reso-nance/gmem-sirva/doc/module.png

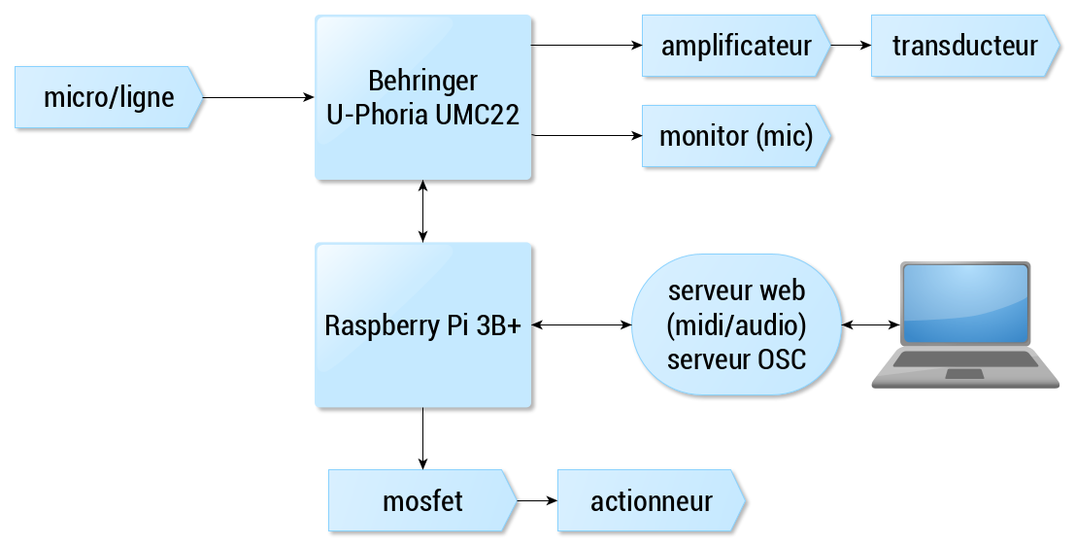
doc/module.png
