reso-nance/gmem-sirva/estimRéplication.ods

Sheet: sans Trig
un module sans trig
Item | Qté | P.U. | P.T | lien
kit Raspberry Pi 3 B+ | 1 | 86,91 € | 86,91 € | https://www.kubii.fr/home/2121-starter-kit-officiel-pi-3-b-kubii-3272496009998.html
carte son UMC202HD | 1 | 66,00 € | 66,00 € | https://www.thomann.de/fr/behringer_u_phoria_umc202hd.htm
ampli audio 10W LM315 | 1 | 9,99 € | 9,99 € | https://www.amazon.fr/ICQUANZX-Simple-dalimentation-Amplificateur-TDA2030A/
embase jack 6.35 | 1 | 7,09 € | 7,09 € | https://www.amazon.fr/Sharplace-6-35mm-Nickel-Plaqué-Terminal/dp/B07D41536V/
embase XLR | 1 | 11,90 € | 11,90 € | https://www.amazon.fr/Embase-Points-Connecteur-Adaptateur-Soudure/dp/B082TZ3G8R/
5x PMMA coulé 4x500x500mm | 1 | 28,97 € | 28,97 € | https://www.polydis.fr/epages/8d7c81fe-552a-11e0-822f-000d609a287c.sf/fr_FR/
Mosfet IRLZ34N | 1 | 17,00 € | 17,00 € | https://www.amazon.fr/DIPU-WULIAN-IRLZ34N-IRLZ34-Effect/dp/B07TWPRW9X
Bras articulé 11’ avec pince | 2 | 27,44 € | 54,88 € | https://www.amazon.fr/Sinvitron-Magique-appareil-numérique-moniteur/dp/B011769YUM/r
Pince vis 1/4 | 2 | 12,50 € | 25,00 € | https://www.amazon.fr/SMALLRIG-Magique-Super-Clamp-Adaptateur/dp/B07F2WRHHF/
câbles, quincaillerie, consommables | 1 | 10,00 € | 10,00 €
Total matériel |  |  | 317,74 €
Installation OS et configuration | 0,5 | 350,00 € | 175,00 €
Fabrication et assemblage boitier | 0,5 | 350,00 € | 175,00 €
Câblage et installation en boitier | 1 | 350,00 € | 350,00 €
Assemblage méca et tests | 2 | 350,00 € | 700,00 €
total main d’oeuvre |  |  | 1 400,00 €
 |  | Total : | 1 717,74 €

Sheet: avec Trig
un module avec trig
Item | Qté | P.U. | P.T | lien
kit Raspberry Pi 3 B+ | 1 | 86,91 € | 86,91 € | https://www.kubii.fr/home/2121-starter-kit-officiel-pi-3-b-kubii-3272496009998.html
carte son UMC202HD | 1 | 66,00 € | 66,00 € | https://www.thomann.de/fr/behringer_u_phoria_umc202hd.htm
ampli audio 10W LM315 | 1 | 9,99 € | 9,99 € | https://www.amazon.fr/ICQUANZX-Simple-dalimentation-Amplificateur-TDA2030A/
embase jack 6.35 | 1 | 7,09 € | 7,09 € | https://www.amazon.fr/Sharplace-6-35mm-Nickel-Plaqué-Terminal/dp/B07D41536V/
embase XLR | 1 | 11,90 € | 11,90 € | https://www.amazon.fr/Embase-Points-Connecteur-Adaptateur-Soudure/dp/B082TZ3G8R/
5x PMMA coulé 4x500x500mm | 1 | 28,97 € | 28,97 € | https://www.polydis.fr/epages/8d7c81fe-552a-11e0-822f-000d609a287c.sf/fr_FR/
MCP3008 | 1 | 5,91 € | 5,91 € | https://www.amazon.fr/MCP3008-Analog-Digital-Converters-10-bit/dp/B01C3PPWSY/
LED RGB 5mm | 1 | 4,69 € | 4,69 € | https://www.amazon.fr/Ruiting-Emitting-Pratique-Produits-Articles/dp/B07HKCP86C/
Potentiomètres 10k linéaires | 1 | 8,99 € | 8,99 € | https://www.amazon.fr/Hseamall-Potentiomètre-rotatif-linéaire-rondelle/dp/B073PQ2G82
PCB simple couche | 1 | 72,00 € | 72,00 € | https://www.pcbway.com/
Mosfet IRLZ34N | 1 | 17,00 € | 17,00 € | https://www.amazon.fr/DIPU-WULIAN-IRLZ34N-IRLZ34-Effect/dp/B07TWPRW9X
Bras articulé 11’ avec pince | 2 | 27,44 € | 54,88 € | https://www.amazon.fr/Sinvitron-Magique-appareil-numérique-moniteur/dp/B011769YUM/r
Pince vis 1/4 | 2 | 12,50 € | 25,00 € | https://www.amazon.fr/SMALLRIG-Magique-Super-Clamp-Adaptateur/dp/B07F2WRHHF/
câbles, quincaillerie, consommables | 1 | 10,00 € | 10,00 €
Total matériel |  |  | 409,33 €
conception PCB | 1,5 | 350,00 € | 525,00 €
Installation OS et configuration | 0,5 | 350,00 € | 175,00 €
Câblage shield raspberry pi | 0,5 | 350,00 € | 175,00 €
Fabrication et assemblage boitier | 0,5 | 350,00 € | 175,00 €
Câblage et installation en boitier | 1 | 350,00 € | 350,00 €
Assemblage méca et tests | 2 | 350,00 € | 700,00 €
total main d’oeuvre |  |  | 2 100,00 €
Total premier module |  |  | 2 509,33 €
Total modules suivants |  |  | 1 912,33 €
