reso-nance/gmem-sirva/hardware/adaptateurSolenoide/Non-Std-Threads.stl

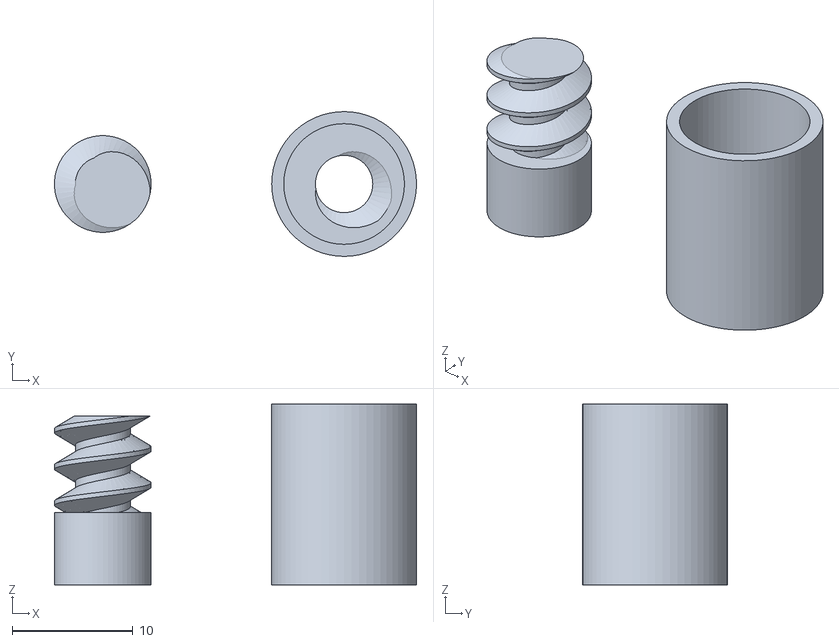
[picture p2: CAD file, 2019-11-29]
hardware/adaptateurSolenoide/Non-Std-Threads.stl
30.0 x 12.0 x 15.0
