reso-nance/gmem-sirva/(list of files, cad)

Other CAD files:
hardware/adaptateurSolenoide/UM2_Non-Std-Threads.stl
