reso-nance/gmem-sirva/(threads)

Thread 4 (2019-10-15):

clients : output volume

reso-nance, 2019-10-15:
the audio volume of each output should be set via OSC. Client should notify the server of it's current volumes on change.

reso-nance, 2019-11-06:
volumes can now be set and read via OSC : set volumes a24e55d9e4c44c3cbd34238cc775979eb2401833 fixed 311877579f709d1556336eedb729a419a5d7334e read volumes 3a40577a17f5b31ae63bd38b483a76863600cbe8

Closed 2019-11-06.
