reso-nance/gmem-sirva/client/main.py

#!/usr/bin/env python
# -*- coding: utf-8 -*-
#
#  client/main.py
#  
#  Copyright 2019 Reso-nance Numérique <laurent@reso-nance.org>
#  
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
#  

from threading import Thread
from time import sleep
import signal, subprocess, atexit, os
import OSCserver, peakDetector, audio

oscServerThread = None
heartbeatThread = None
peakDetectorThread = None
JACKconnectionThread = None

def exitCleanly(*args): #args may contain SIGnumber and other info when called from atexit
    if oscServerThread : 
        print("stopping the heartbeat")
        OSCserver.heartbeat = False
        heartbeatThread.join()
        print("closing the OSC server")
        OSCserver.runServer = False
    if peakDetector :
        print("closing the peak detector")
        peakDetector.isListening = False
        peakDetector.stopListening()
    print("exiting jack client ...")
    audio.close()
    
    raise SystemExit



if __name__ == '__main__':
    signal.signal(signal.SIGTERM, exitCleanly) # register this exitCleanly function to be called on sigterm
    atexit.register(exitCleanly) # idem when called from within this script
    if not os.path.isdir(audio.wavDir) : os.mkdir(audio.wavDir) # create the wav directory if it does'nt already exists
    print("starting the OSC server...")
    oscServerThread = Thread(target=OSCserver.listen)
    oscServerThread.start()
    print("starting the heartbeat thread ...")
    heartbeatThread = Thread(target = OSCserver.sendHeartbeat)
    heartbeatThread.start()
    print("starting the audio peak detector...")
    peakDetectorThread = Thread(target=peakDetector.listen)
    peakDetectorThread.start()
    print("starting the JACK connection thread...")
    JACKconnectionThread = Thread(target=audio.init, kwargs=audio.jackParameters)
    JACKconnectionThread.start()
    

    while True :
        try : sleep(1)
        except KeyboardInterrupt : exitCleanly()
