reso-nance/gmem-sirva/(commit log)

2019-09-10 added a setup script added an OSCserver added a midi file player sending OSC packages to local addresses stored in a json midi-hostnames containing the velocity of the note played
2019-09-10 added untested client code : convert note velocity to gpio high duration to actuate the solenoid according to the midi velocity
2019-09-11 added a peak detector for the client added an OSC server for the client added and tested basic GPIO functions deployed and fixed client setup script
    [OSCserver.py, main.py, peakDetector.py, solenoid.py]
2019-09-12 added SPI support to read potentiometers through MCP3008 on the client side cleaned peak detector code added OSC server back in the repo
2019-09-18 fixed threads won't exit cleanly soundcard is now found by it's name in both ALSA and OSS enumeration protocols added an RBG led with signal/peak functionnality commented client code
    [OSCserver.py, main.py, peakDetector.py, solenoid.py]
2019-09-30 tested and fixed OSC mute, unmute, toggle, route on all channels cleaned and commented audio code added some xrun stats to ease tweaking jack parameters removed jack process callback (not used anymor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
    [OSCserver.py, audio.py, main.py, solenoid.py]
2019-10-28 added a heartbeat with discovery from clients to server. New clients are asked to send their local IP, volumes from alsamixer, wav files list and assigned midi note to the server clients can read the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
    [OSCserver.py, audio.py, main.py, peakDetector.py, solenoid.py]
2019-10-29 midi note is now stored in a file on the client side. If this file doesn't exist, a random note will be assigned tested and fixed heartbeat, sendInfos, filesList server will now check for disconnecte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
    [OSCserver.py, main.py]
2019-10-31 added hostname change without reboot clients will notify server on volume change added function descriptions on the "clients.py" server module added "/whoIsThere" and "/knownClients" functionnalities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
    [OSCserver.py, audio.py, main.py]
2019-10-31 cosmetic changes, fixed CSS and html on status list and devices list
2019-10-31 added bindings to play files via UI added refresh files list on UI set timeout to 5 secs, lower could flag a device disconnected during sftp transfers fixed play file over OSC
    [OSCserver.py, audio.py]
2019-11-04 added client audio stop function added client disconnect function to disconnect previously set routes added client delete function to remove audiofiles from the client tested client setup script on r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
    [OSCserver.py, audio.py, main.py, peakDetector.py, solenoid.py]
2019-11-07 added stop function from UI when playing wav files on the client fixed UI volumes refresh (namespace bug and JS selector) remapped the volume between UI and alsamixer : volumes below 40% tends to be 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
    [OSCserver.py, audio.py]
2019-11-07 rewrote midi file playing function to use knownClients file fixed midi note update from UI added play, stop, delete and send midi files list to UI
    [OSCserver.py]
2019-11-07 fixed midi velocity to ms actuation conversion fixed midi read from server
    [OSCserver.py, solenoid.py]
2019-11-29 added physical part solenoid adapter untracked geany project file to transition over VSCode
    [M3threads.scad, Non-Std-Threads.scad, Non-Std-Threads.stl, UM2_Non-Std-Threads.stl]
2019-12-11 fixed wav file upload and dispatch added shutdown from frontend
    [OSCserver.py, main.py]
2020-02-10 tried to fix solenoid not activating all the way on rapide fire (WIP, still unsolved)
    [peakDetector.py, solenoid.py]
2020-02-10 fixed solenoid rapid fire error : using timedelta in a while loop instead of time.sleep
    [solenoid.py]
2020-02-10 fixed client autolaunch, displays automatically every connecter module on the UI
    [main.py]
2020-02-27 fixed font path, server setup script, midinote change from UI, tweaked audio parameters
    [estimRéplication.ods]
