reso-nance/gmem-sirva/(notices)

Notices in the files:
client/solenoid.py:
the Free Software Foundation; either version 2 of the License, or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
